schlae/EGACard/EGACard.kicad_sch

## KiCad design EGACard.kicad_sch (2024-01-29)

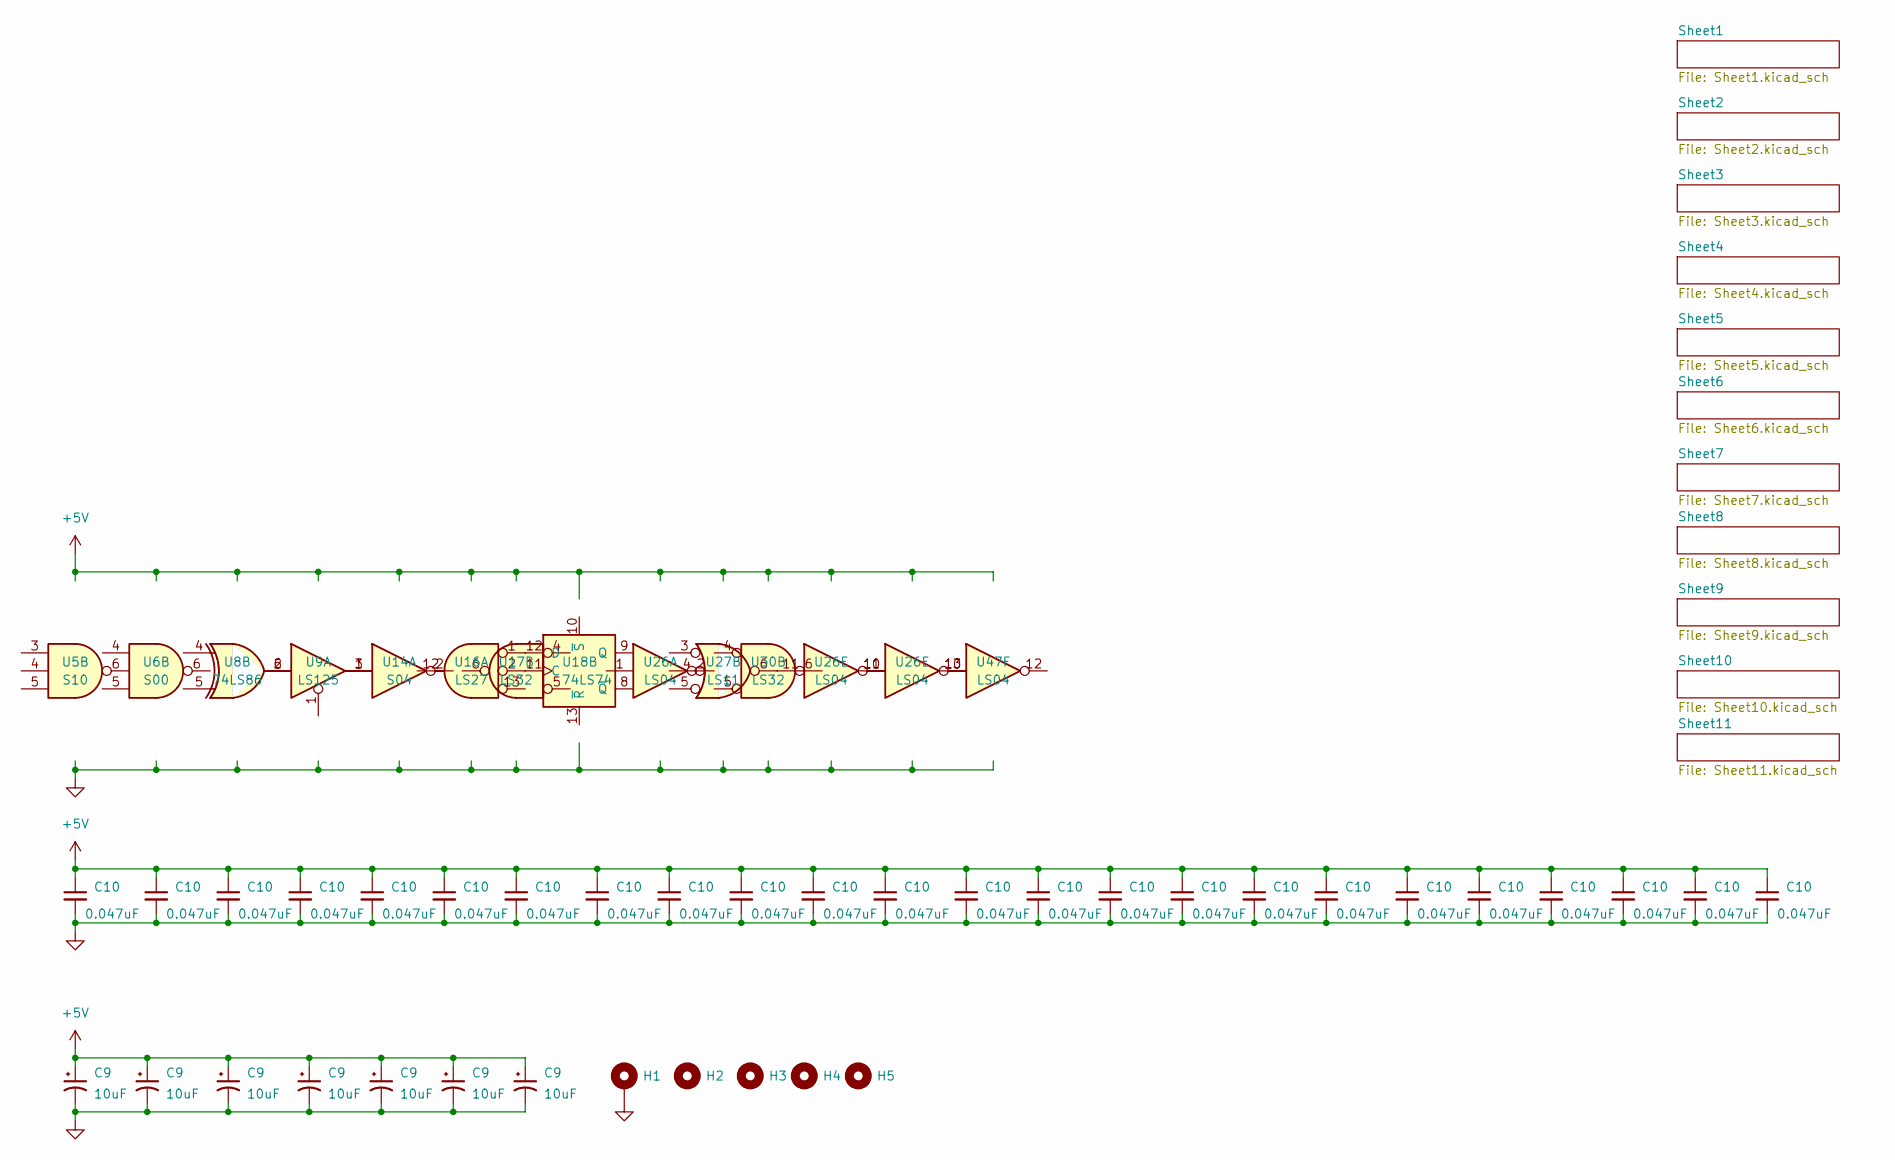
[picture p2: schematic EGACard.kicad_sch]

Parts:
C9: 10uF; CAPAP200_ALT
C10: 0.047uF; CAPAC1234
H1: MountingHole_Pad; MH125
H2: MountingHole; MH125_NOPAD
H3, H4, H5: MountingHole; MH156_NOPAD
U5: S10; DIP254P762X635-14
U6: S00; DIP254P762X635-14
U8: 74LS86; DIP254P762X635-14
U9: LS125; DIP254P762X635-14
U14: S04; DIP254P762X635-14
U16: LS27; DIP254P762X635-14
U17, U30: LS32; DIP254P762X635-14
U18: 74LS74; DIP254P762X635-14
U26, U47: LS04; DIP254P762X635-14
U27: LS11; DIP254P762X635-14

Connections:
+5V: C9.1, C10.1
GND: C9.2, C10.2, H1.1
unnamed: U16.1, U18.12 (D)
unnamed: U16.2, U18.11 (C)
unnamed: U26.11, U27.6
