schlae/EGACard/Sheet1.kicad_sch

## KiCad design Sheet1.kicad_sch (2024-01-20)

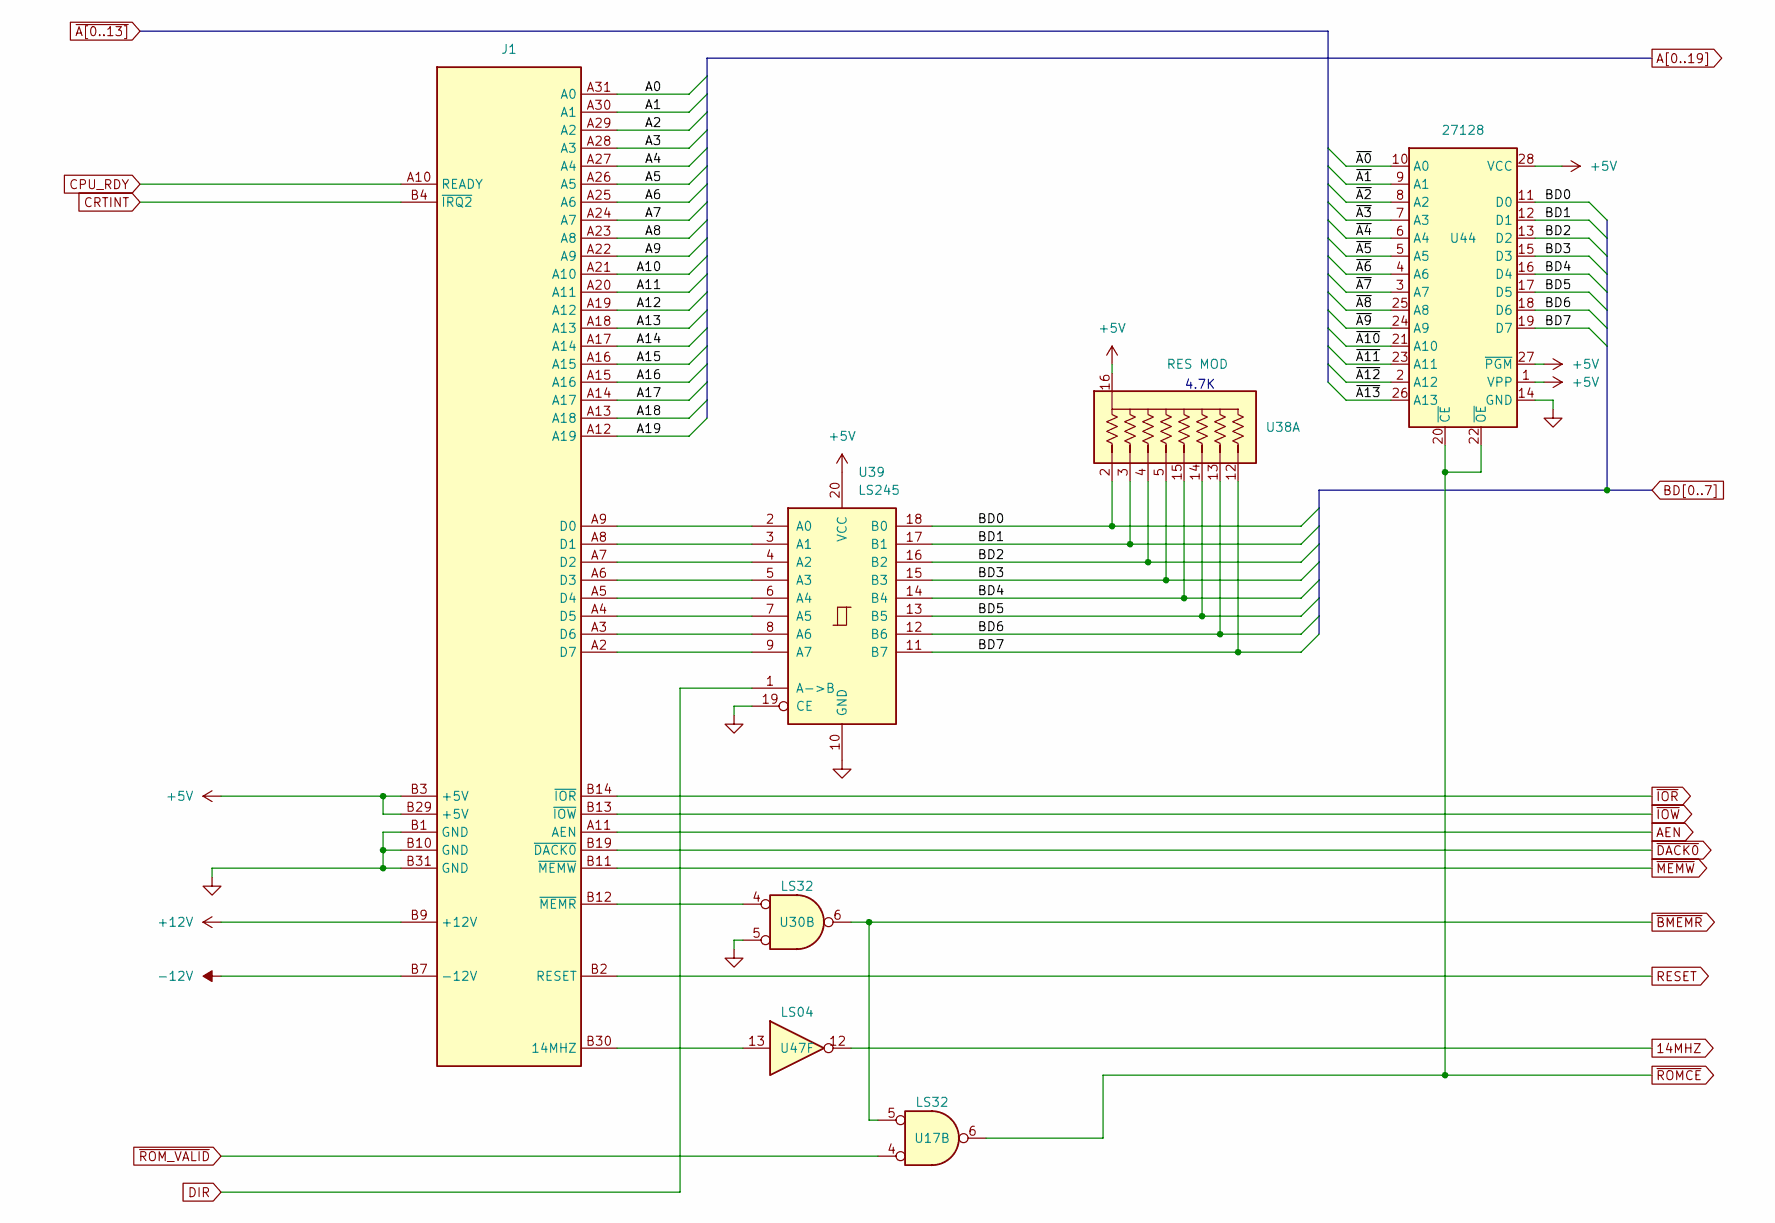
[picture p3: schematic Sheet1.kicad_sch]

Parts:
J1: BUS_PC_8BIT
U17, U30: LS32; DIP254P762X635-14
U38: RES MOD; DIP254P762X635-16
U39: LS245; DIP254P762X635-20
U44: 27128; DIP254P1524X635-28
U47: LS04; DIP254P762X635-14

Connections:
14MHZ: U47.12
+5V: J1.B3 (+5V), J1.B29 (+5V), U38.16, U39.20 (VCC), U44.1 (VPP), U44.27 (~PGM), U44.28 (VCC)
+12V: J1.B9 (+12V)
-12V: J1.B7 (-12V)
A0: J1.A31 (A0)
A1: J1.A30 (A1)
A2: J1.A29 (A2)
A3: J1.A28 (A3)
A4: J1.A27 (A4)
A5: J1.A26 (A5)
A6: J1.A25 (A6)
A7: J1.A24 (A7)
A8: J1.A23 (A8)
A9: J1.A22 (A9)
A10: J1.A21 (A10)
A11: J1.A20 (A11)
A12: J1.A19 (A12)
A13: J1.A18 (A13)
A14: J1.A17 (A14)
A15: J1.A16 (A15)
A16: J1.A15 (A16)
A17: J1.A14 (A17)
A18: J1.A13 (A18)
A19: J1.A12 (A19)
AEN: J1.A11 (AEN)
BD0: U38.2, U39.18 (B0), U44.11 (D0)
BD1: U38.3, U39.17 (B1), U44.12 (D1)
BD2: U38.4, U39.16 (B2), U44.13 (D2)
BD3: U38.5, U39.15 (B3), U44.15 (D3)
BD4: U38.15, U39.14 (B4), U44.16 (D4)
BD5: U38.14, U39.13 (B5), U44.17 (D5)
BD6: U38.13, U39.12 (B6), U44.18 (D6)
BD7: U38.12, U39.11 (B7), U44.19 (D7)
CPU_RDY: J1.A10 (READY)
CRTINT: J1.B4 (~IRQ2)
DIR: U39.1 (A->B)
GND: J1.B1 (GND), J1.B10 (GND), J1.B31 (GND), U30.5, U39.10 (GND), U39.19 (CE), U44.14 (GND)
unnamed: J1.A2 (D7), U39.9 (A7)
unnamed: J1.A3 (D6), U39.8 (A6)
unnamed: J1.A4 (D5), U39.7 (A5)
unnamed: J1.A5 (D4), U39.6 (A4)
unnamed: J1.A6 (D3), U39.5 (A3)
unnamed: J1.A7 (D2), U39.4 (A2)
unnamed: J1.A8 (D1), U39.3 (A1)
unnamed: J1.A9 (D0), U39.2 (A0)
unnamed: J1.B12 (~MEMR), U30.4
unnamed: J1.B30 (14MHZ), U47.13
RESET: J1.B2 (RESET)
~A0: U44.10 (A0)
~A1: U44.9 (A1)
~A2: U44.8 (A2)
~A3: U44.7 (A3)
~A4: U44.6 (A4)
~A5: U44.5 (A5)
~A6: U44.4 (A6)
~A7: U44.3 (A7)
~A8: U44.25 (A8)
~A9: U44.24 (A9)
~A10: U44.21 (A10)
~A11: U44.23 (A11)
~A12: U44.2 (A12)
~A13: U44.26 (A13)
~BMEMR: U17.5, U30.6
~DACK0: J1.B19 (~DACK0)
~IOR: J1.B14 (~IOR)
~IOW: J1.B13 (~IOW)
~MEMW: J1.B11 (~MEMW)
~ROMCE: U17.6, U44.20 (~CE), U44.22 (~OE)
~ROM_VALID: U17.4

Notes on the sheet:
4.7K
