schlae/EGACard/Sheet2.kicad_sch

## KiCad design Sheet2.kicad_sch (2024-01-29)

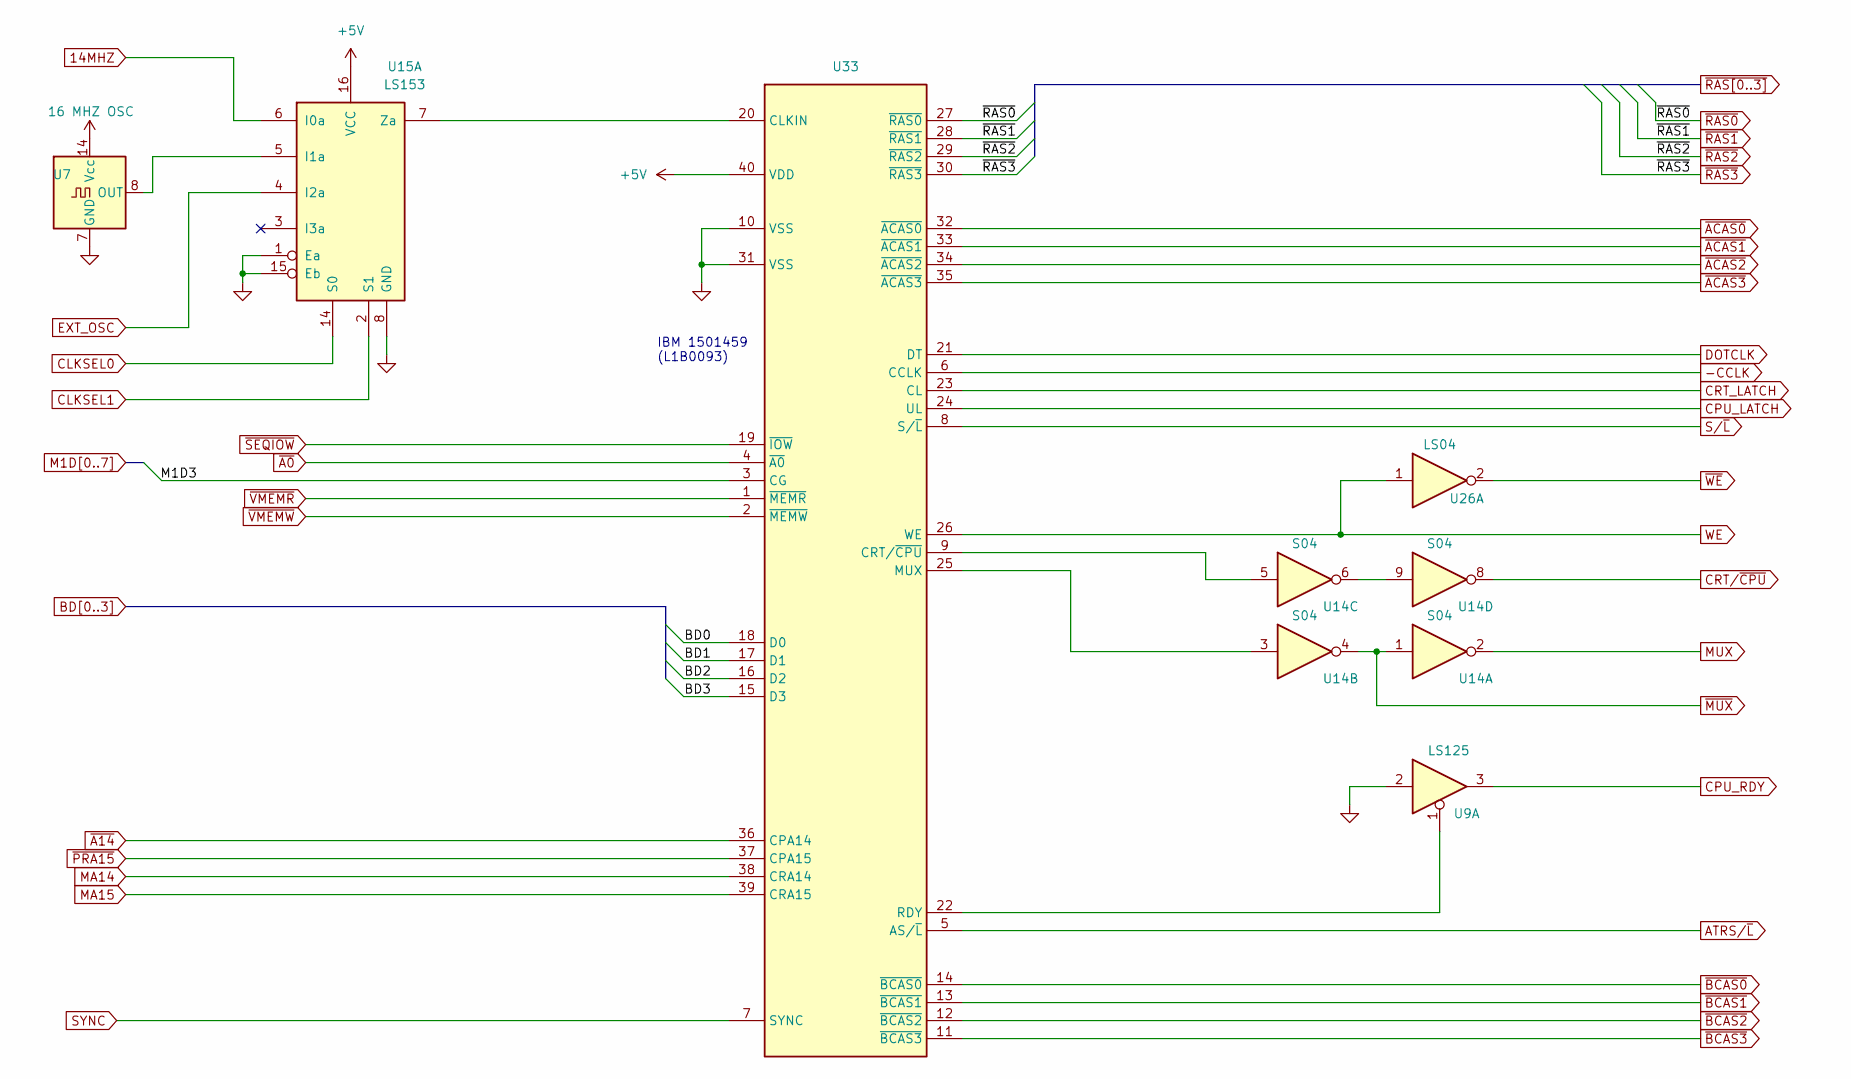
[picture p4: schematic Sheet2.kicad_sch]

Parts:
U7: 16 MHZ OSC; DIP254P762X635-14_ALT
U9: LS125; DIP254P762X635-14
U14: S04; DIP254P762X635-14
U15: LS153; DIP254P762X635-16
U26: LS04; DIP254P762X635-14
U33: DIP254P1524X635-40

Connections:
14MHZ: U15.6 (I0a)
+5V: U7.14 (Vcc), U15.16 (VCC), U33.40 (VDD)
-CCLK: U33.6 (CCLK)
ATRS/~L: U33.5 (AS/~L)
BD0: U33.18 (D0)
BD1: U33.17 (D1)
BD2: U33.16 (D2)
BD3: U33.15 (D3)
CLKSEL0: U15.14 (S0)
CLKSEL1: U15.2 (S1)
CPU_LATCH: U33.24 (UL)
CPU_RDY: U9.3
CRT_LATCH: U33.23 (CL)
CRT/~CPU: U14.8
DOTCLK: U33.21 (DT)
EXT_OSC: U15.4 (I2a)
GND: U7.7 (GND), U9.2, U15.1 (Ea), U15.8 (GND), U15.15 (Eb), U33.10 (VSS), U33.31 (VSS)
M1D3: U33.3 (CG)
MA14: U33.38 (CRA14)
MA15: U33.39 (CRA15)
MUX: U14.2
unnamed: U14.3, U33.25 (MUX)
unnamed: U14.5, U33.9 (CRT/~CPU)
unnamed: U14.6, U14.9
unnamed: U7.8 (OUT), U15.5 (I1a)
unnamed: U15.7 (Za), U33.20 (CLKIN)
unnamed: U9.1, U33.22 (RDY)
SYNC: U33.7 (SYNC)
S/~L: U33.8 (S/~L)
WE: U26.1, U33.26 (WE)
~A0: U33.4 (~A0)
~A14: U33.36 (CPA14)
~ACAS0: U33.32 (~ACAS0)
~ACAS1: U33.33 (~ACAS1)
~ACAS2: U33.34 (~ACAS2)
~ACAS3: U33.35 (~ACAS3)
~BCAS0: U33.14 (~BCAS0)
~BCAS1: U33.13 (~BCAS1)
~BCAS2: U33.12 (~BCAS2)
~BCAS3: U33.11 (~BCAS3)
~MUX: U14.1, U14.4
~PRA15: U33.37 (CPA15)
~RAS0: U33.27 (~RAS0)
~RAS1: U33.28 (~RAS1)
~RAS2: U33.29 (~RAS2)
~RAS3: U33.30 (~RAS3)
~SEQIOW: U33.19 (~IOW)
~VMEMR: U33.1 (~MEMR)
~VMEMW: U33.2 (~MEMW)
~WE: U26.2

Notes on the sheet:
IBM 1501459 (L1B0093)
