schlae/EGACard/Sheet3.kicad_sch

## KiCad design Sheet3.kicad_sch (2024-01-29)

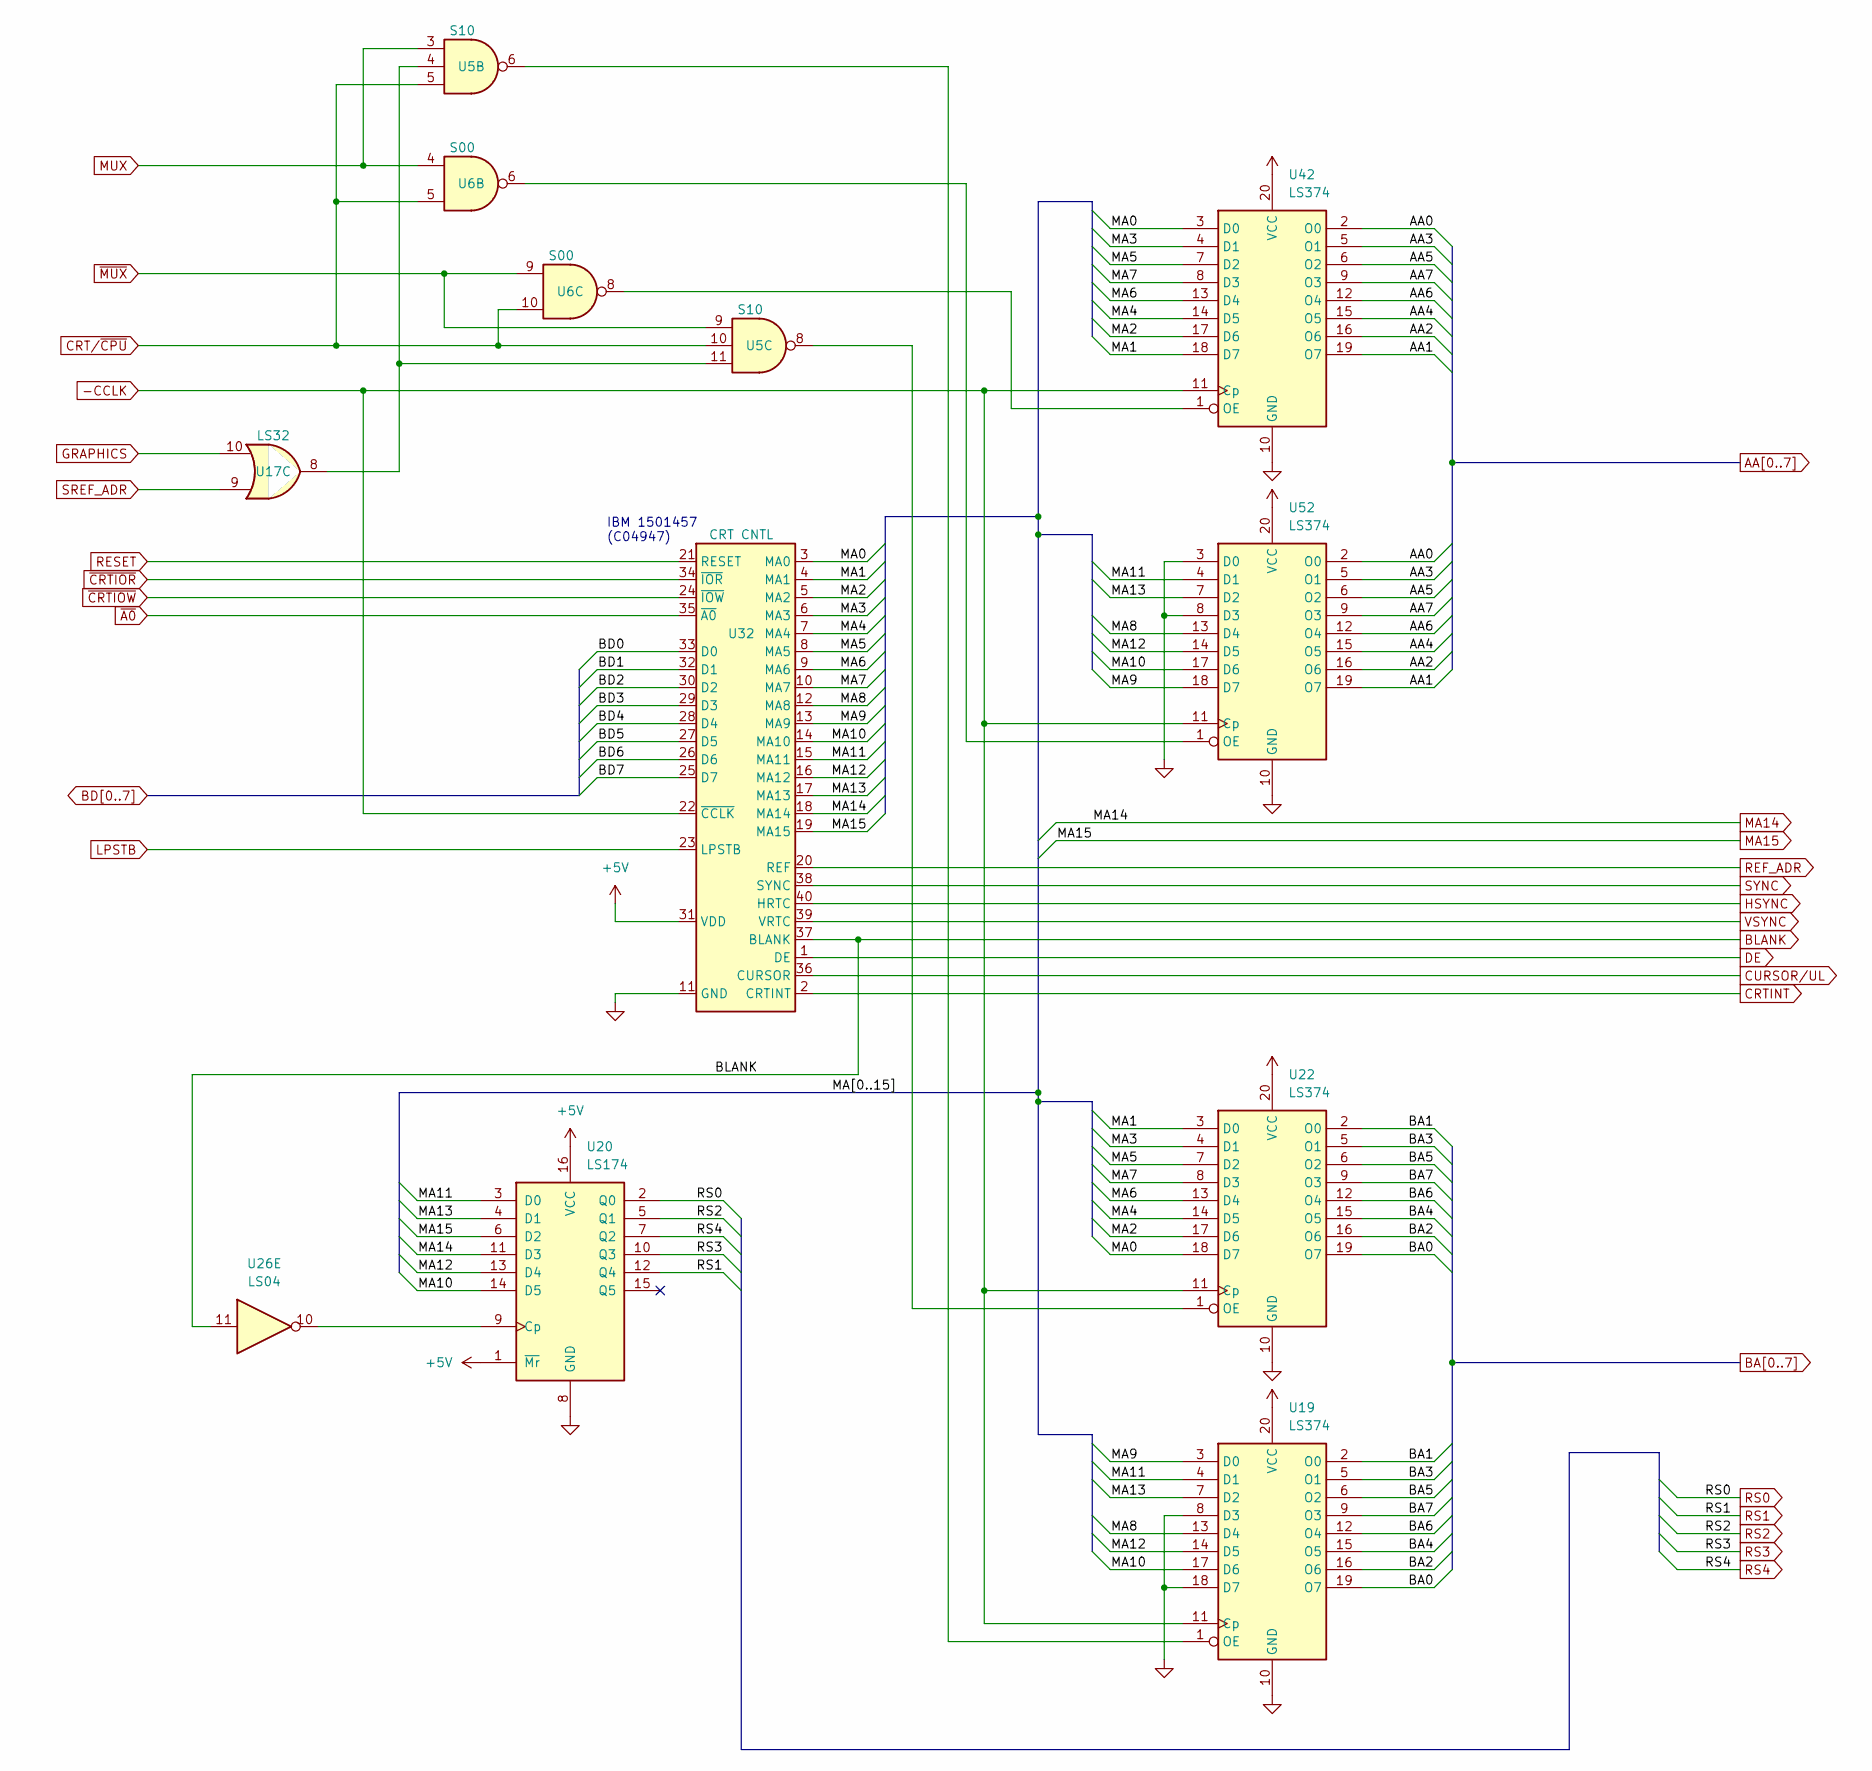
[picture p5: schematic Sheet3.kicad_sch]

Parts:
U5: S10; DIP254P762X635-14
U6: S00; DIP254P762X635-14
U17: LS32; DIP254P762X635-14
U19, U22, U42, U52: LS374; DIP254P762X635-20
U20: LS174; DIP254P762X635-16
U26: LS04; DIP254P762X635-14
U32: CRT CNTL; DIP254P1524X635-40

Connections:
+5V: U19.20 (VCC), U20.1 (~Mr), U20.16 (VCC), U22.20 (VCC), U32.31 (VDD), U42.20 (VCC), U52.20 (VCC)
-CCLK: U19.11 (Cp), U22.11 (Cp), U32.22 (~CCLK), U42.11 (Cp), U52.11 (Cp)
AA0: U42.2 (O0), U52.2 (O0)
AA1: U42.19 (O7), U52.19 (O7)
AA2: U42.16 (O6), U52.16 (O6)
AA3: U42.5 (O1), U52.5 (O1)
AA4: U42.15 (O5), U52.15 (O5)
AA5: U42.6 (O2), U52.6 (O2)
AA6: U42.12 (O4), U52.12 (O4)
AA7: U42.9 (O3), U52.9 (O3)
BA0: U19.19 (O7), U22.19 (O7)
BA1: U19.2 (O0), U22.2 (O0)
BA2: U19.16 (O6), U22.16 (O6)
BA3: U19.5 (O1), U22.5 (O1)
BA4: U19.15 (O5), U22.15 (O5)
BA5: U19.6 (O2), U22.6 (O2)
BA6: U19.12 (O4), U22.12 (O4)
BA7: U19.9 (O3), U22.9 (O3)
BD0: U32.33 (D0)
BD1: U32.32 (D1)
BD2: U32.30 (D2)
BD3: U32.29 (D3)
BD4: U32.28 (D4)
BD5: U32.27 (D5)
BD6: U32.26 (D6)
BD7: U32.25 (D7)
BLANK: U26.11, U32.37 (BLANK)
CRTINT: U32.2 (CRTINT)
CRT/~CPU: U5.5, U5.10, U6.5, U6.10
CURSOR/UL: U32.36 (CURSOR)
DE: U32.1 (DE)
GND: U19.8 (D3), U19.10 (GND), U19.18 (D7), U20.8 (GND), U22.10 (GND), U32.11 (GND), U42.10 (GND), U52.3 (D0), U52.8 (D3), U52.10 (GND)
GRAPHICS: U17.10
HSYNC: U32.40 (HRTC)
LPSTB: U32.23 (LPSTB)
MA0: U22.18 (D7), U32.3 (MA0), U42.3 (D0)
MA1: U22.3 (D0), U32.4 (MA1), U42.18 (D7)
MA2: U22.17 (D6), U32.5 (MA2), U42.17 (D6)
MA3: U22.4 (D1), U32.6 (MA3), U42.4 (D1)
MA4: U22.14 (D5), U32.7 (MA4), U42.14 (D5)
MA5: U22.7 (D2), U32.8 (MA5), U42.7 (D2)
MA6: U22.13 (D4), U32.9 (MA6), U42.13 (D4)
MA7: U22.8 (D3), U32.10 (MA7), U42.8 (D3)
MA8: U19.13 (D4), U32.12 (MA8), U52.13 (D4)
MA9: U19.3 (D0), U32.13 (MA9), U52.18 (D7)
MA10: U19.17 (D6), U20.14 (D5), U32.14 (MA10), U52.17 (D6)
MA11: U19.4 (D1), U20.3 (D0), U32.15 (MA11), U52.4 (D1)
MA12: U19.14 (D5), U20.13 (D4), U32.16 (MA12), U52.14 (D5)
MA13: U19.7 (D2), U20.4 (D1), U32.17 (MA13), U52.7 (D2)
MA14: U20.11 (D3), U32.18 (MA14)
MA15: U20.6 (D2), U32.19 (MA15)
MUX: U5.3, U6.4
unnamed: U5.4, U5.11, U17.8
unnamed: U5.6, U19.1 (OE)
unnamed: U20.9 (Cp), U26.10
unnamed: U5.8, U22.1 (OE)
unnamed: U6.8, U42.1 (OE)
unnamed: U6.6, U52.1 (OE)
REF_ADR: U32.20 (REF)
RESET: U32.21 (RESET)
RS0: U20.2 (Q0)
RS1: U20.12 (Q4)
RS2: U20.5 (Q1)
RS3: U20.10 (Q3)
RS4: U20.7 (Q2)
SREF_ADR: U17.9
SYNC: U32.38 (SYNC)
VSYNC: U32.39 (VRTC)
~A0: U32.35 (~A0)
~CRTIOR: U32.34 (~IOR)
~CRTIOW: U32.24 (~IOW)
~MUX: U5.9, U6.9

Notes on the sheet:
IBM 1501457 (C04947)
