schlae/EGACard/Sheet4.kicad_sch

## KiCad design Sheet4.kicad_sch (2024-01-20)

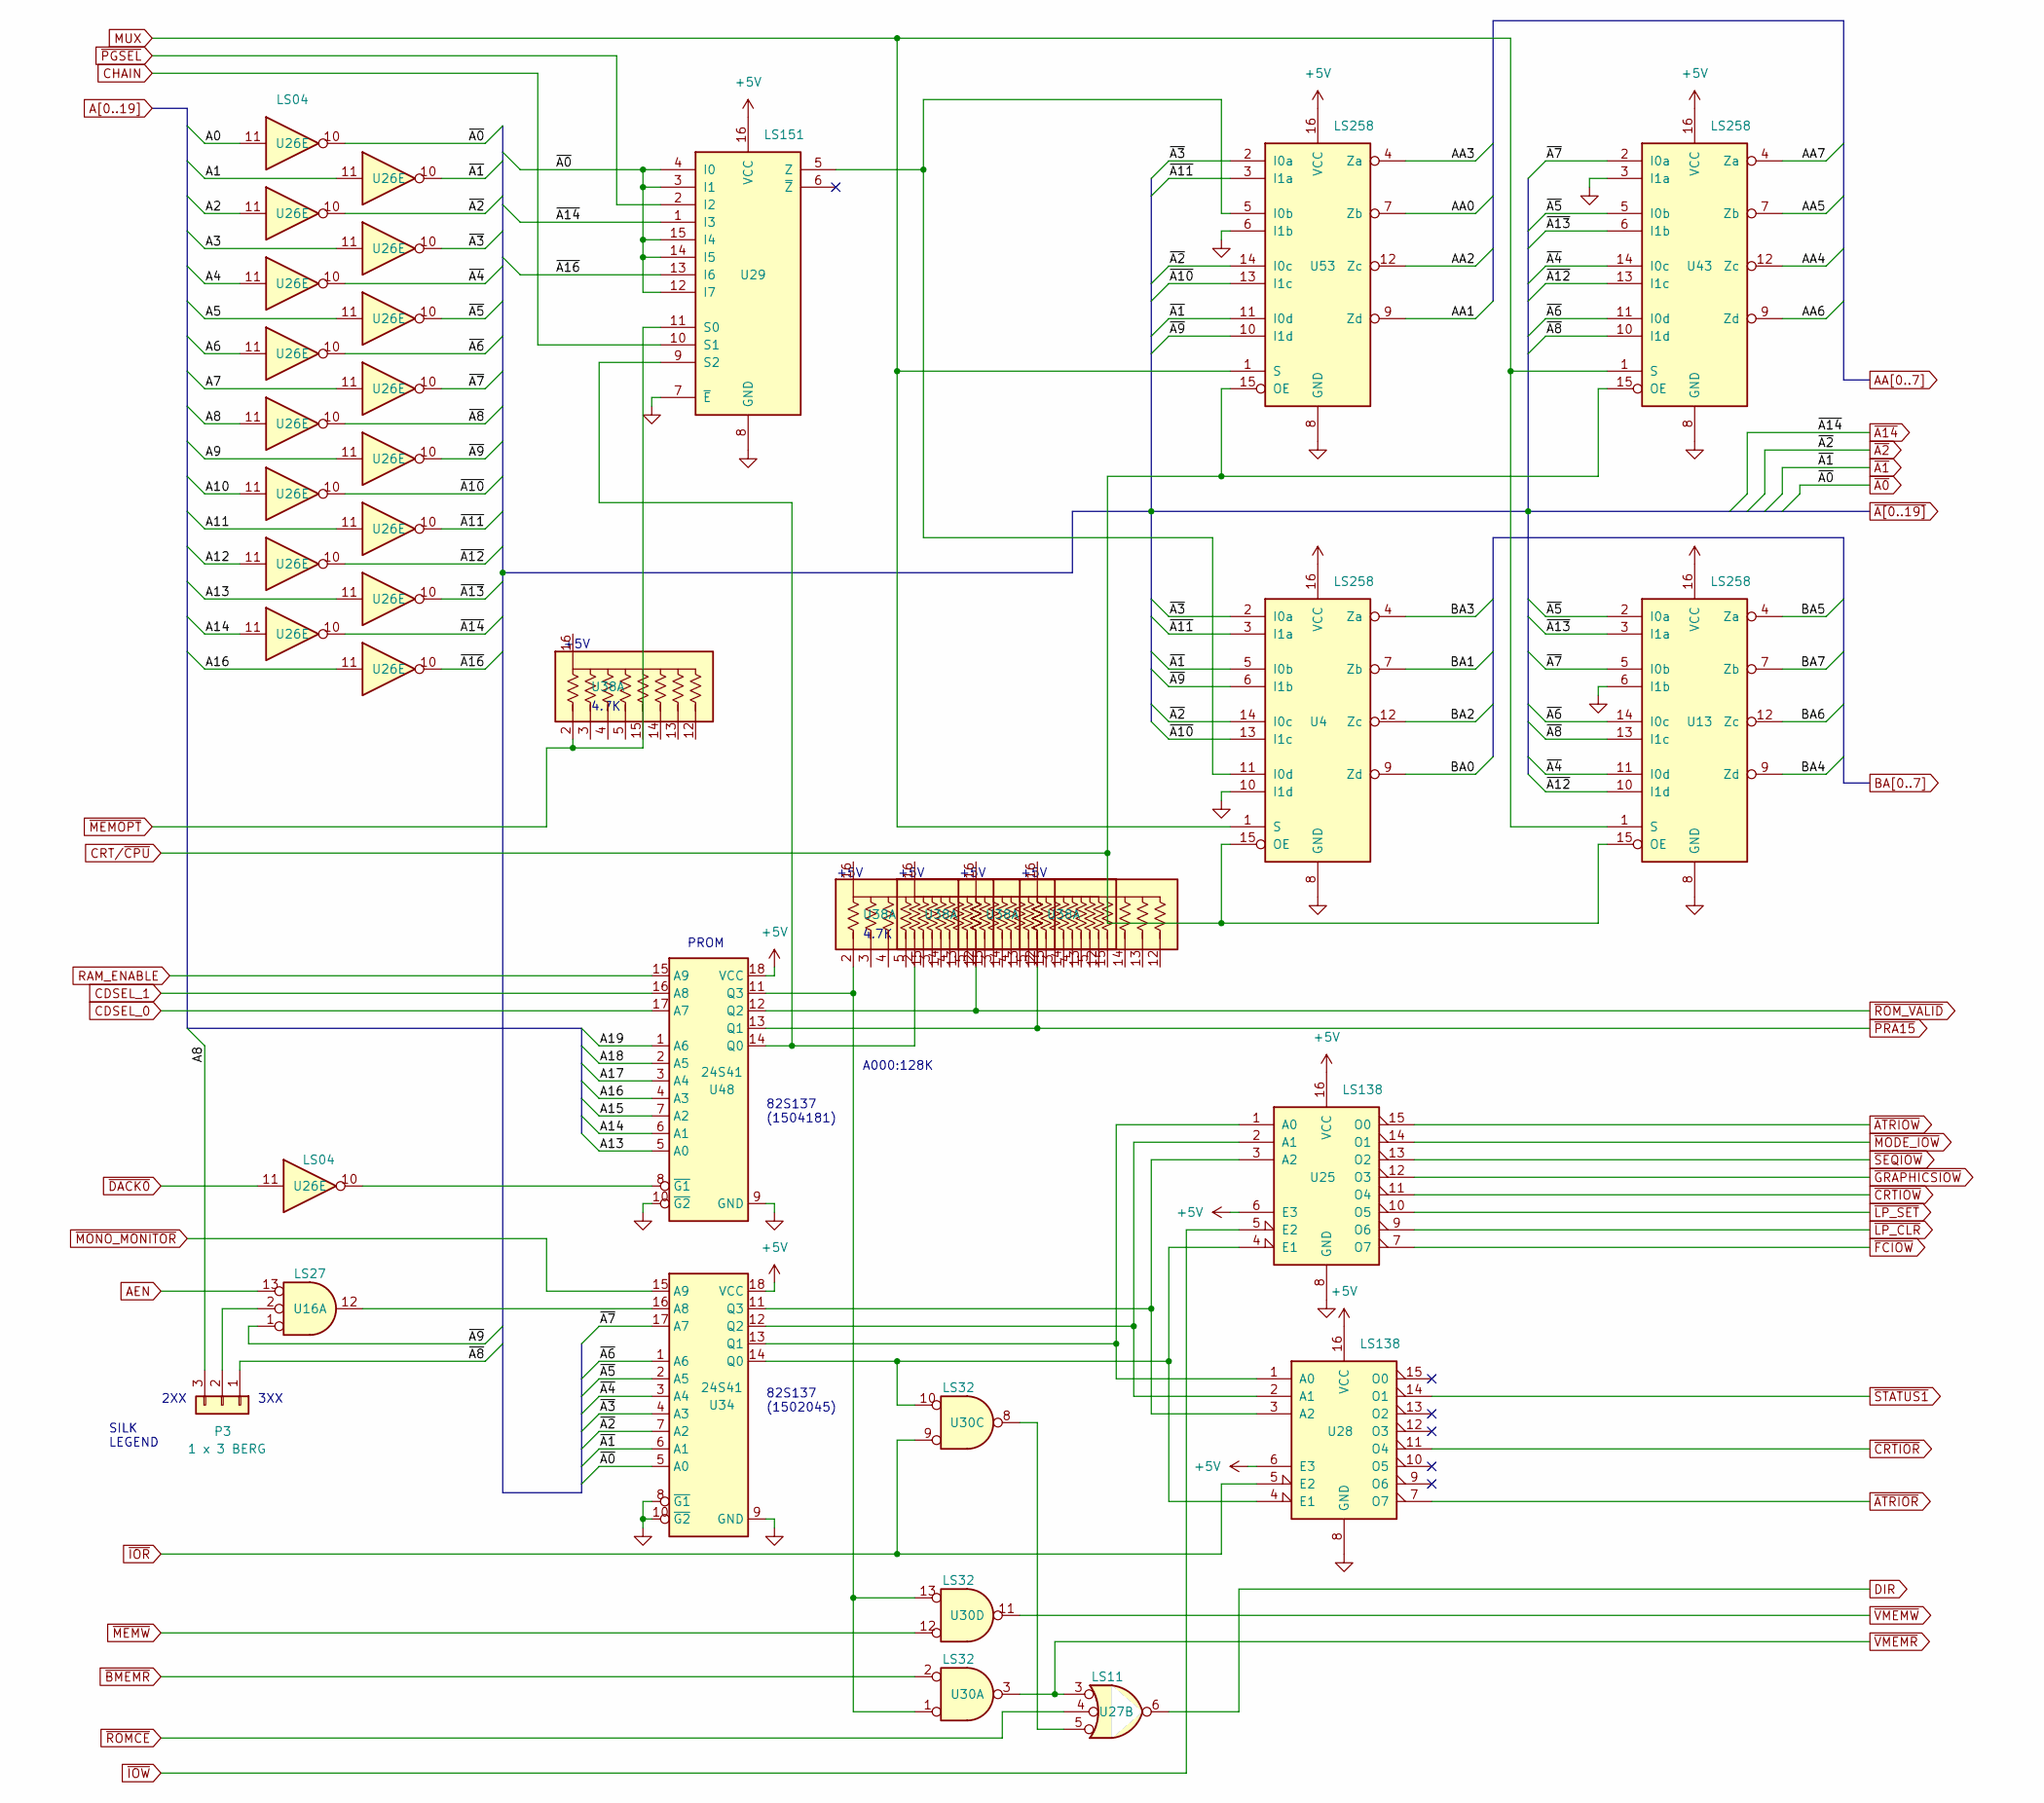
[picture p6: schematic Sheet4.kicad_sch]

Parts:
P3: 1 x 3 BERG; PinHeader_1x03_P2.54mm_Vertical
U4, U13, U43, U53: LS258; DIP254P762X635-16
U16: LS27; DIP254P762X635-14
U25, U28: LS138; DIP254P762X635-16
U26: LS04; DIP254P762X635-14
U27: LS11; DIP254P762X635-14
U29: LS151; DIP254P762X635-16
U30: LS32; DIP254P762X635-14
U34, U48: 24S41; DIP254P762X635-18
U38: RES MOD; DIP254P762X635-16

Connections:
+5V: U4.16 (VCC), U13.16 (VCC), U25.6 (E3), U25.16 (VCC), U28.6 (E3), U28.16 (VCC), U29.16 (VCC), U34.18 (VCC), U43.16 (VCC), U48.18 (VCC), U53.16 (VCC)
A0: U26.11
A1: U26.11
A2: U26.11
A3: U26.11
A4: U26.11
A5: U26.11
A6: U26.11
A7: U26.11
A8: P3.3, U26.11
A9: U26.11
A10: U26.11
A11: U26.11
A12: U26.11
A13: U26.11, U48.5 (A0)
A14: U26.11, U48.6 (A1)
A15: U48.7 (A2)
A16: U26.11, U48.4 (A3)
A17: U48.3 (A4)
A18: U48.2 (A5)
A19: U48.1 (A6)
AA0: U53.7 (Zb)
AA1: U53.9 (Zd)
AA2: U53.12 (Zc)
AA3: U53.4 (Za)
AA4: U43.12 (Zc)
AA5: U43.7 (Zb)
AA6: U43.9 (Zd)
AA7: U43.4 (Za)
AEN: U16.13
BA0: U4.9 (Zd)
BA1: U4.7 (Zb)
BA2: U4.12 (Zc)
BA3: U4.4 (Za)
BA4: U13.9 (Zd)
BA5: U13.4 (Za)
BA6: U13.12 (Zc)
BA7: U13.7 (Zb)
CDSEL_0: U48.17 (A7)
CDSEL_1: U48.16 (A8)
CHAIN: U29.10 (S1)
CRT/~CPU: U4.15 (OE), U13.15 (OE), U43.15 (OE), U53.15 (OE)
DIR: U27.6
GND: U4.8 (GND), U4.10 (I1d), U13.6 (I1b), U13.8 (GND), U25.8 (GND), U28.8 (GND), U29.7 (~E), U29.8 (GND), U34.8 (~G1), U34.9 (GND), U34.10 (~G2), U43.3 (I1a), U43.8 (GND), U48.9 (GND), U48.10 (~G2), U53.6 (I1b), U53.8 (GND)
MUX: U4.1 (S), U13.1 (S), U43.1 (S), U53.1 (S)
unnamed: P3.2, U16.2
unnamed: U16.12, U34.16 (A8)
unnamed: U25.1 (A0), U28.1 (A0), U34.13 (Q1)
unnamed: U25.2 (A1), U28.2 (A1), U34.12 (Q2)
unnamed: U25.3 (A2), U28.3 (A2), U34.11 (Q3)
unnamed: U25.4 (E1), U28.4 (E1), U30.10, U34.14 (Q0)
unnamed: U26.10, U48.8 (~G1)
unnamed: U27.5, U30.8
unnamed: U4.11 (I0d), U29.5 (Z), U53.5 (I0b)
unnamed: U29.9 (S2), U38.2, U48.14 (Q0)
unnamed: U30.1, U30.13, U38.2, U48.11 (Q3)
RAM_ENABLE: U48.15 (A9)
~A0: U26.10, U29.3 (I1), U29.4 (I0), U29.12 (I7), U29.14 (I5), U29.15 (I4), U34.5 (A0)
~A1: U4.5 (I0b), U26.10, U34.6 (A1), U53.11 (I0d)
~A2: U4.14 (I0c), U26.10, U34.7 (A2), U53.14 (I0c)
~A3: U4.2 (I0a), U26.10, U34.4 (A3), U53.2 (I0a)
~A4: U13.11 (I0d), U26.10, U34.3 (A4), U43.14 (I0c)
~A5: U13.2 (I0a), U26.10, U34.2 (A5), U43.5 (I0b)
~A6: U13.14 (I0c), U26.10, U34.1 (A6), U43.11 (I0d)
~A7: U13.5 (I0b), U26.10, U34.17 (A7), U43.2 (I0a)
~A8: P3.1, U13.13 (I1c), U26.10, U43.10 (I1d)
~A9: U4.6 (I1b), U16.1, U26.10, U53.10 (I1d)
~A10: U4.13 (I1c), U26.10, U53.13 (I1c)
~A11: U4.3 (I1a), U26.10, U53.3 (I1a)
~A12: U13.10 (I1d), U26.10, U43.13 (I1c)
~A13: U13.3 (I1a), U26.10, U43.6 (I1b)
~A14: U26.10, U29.1 (I3)
~A16: U26.10, U29.13 (I6)
~ATRIOR: U28.7 (O7)
~ATRIOW: U25.15 (O0)
~BMEMR: U30.2
~CRTIOR: U28.11 (O4)
~CRTIOW: U25.11 (O4)
~DACK0: U26.11
~FCIOW: U25.7 (O7)
~GRAPHICSIOW: U25.12 (O3)
~IOR: U28.5 (E2), U30.9
~IOW: U25.5 (E2)
~LP_CLR: U25.9 (O6)
~LP_SET: U25.10 (O5)
~MEMOPT: U29.11 (S0), U38.2
~MEMW: U30.12
~MODE_IOW: U25.14 (O1)
~MONO_MONITOR: U34.15 (A9)
~PGSEL: U29.2 (I2)
~PRA15: U38.2, U38.12, U48.13 (Q1)
~ROMCE: U27.4
~ROM_VALID: U38.2, U38.12, U48.12 (Q2)
~SEQIOW: U25.13 (O2)
~STATUS1: U28.14 (O1)
~VMEMR: U27.3, U30.3
~VMEMW: U30.11

Notes on the sheet:
82S137 (1504181)
+5V
PROM
4.7K
A000:128K
2XX
82S137 (1502045)
SILK LEGEND
3XX
