schlae/EGACard/Sheet5.kicad_sch

## KiCad design Sheet5.kicad_sch (2024-01-29)

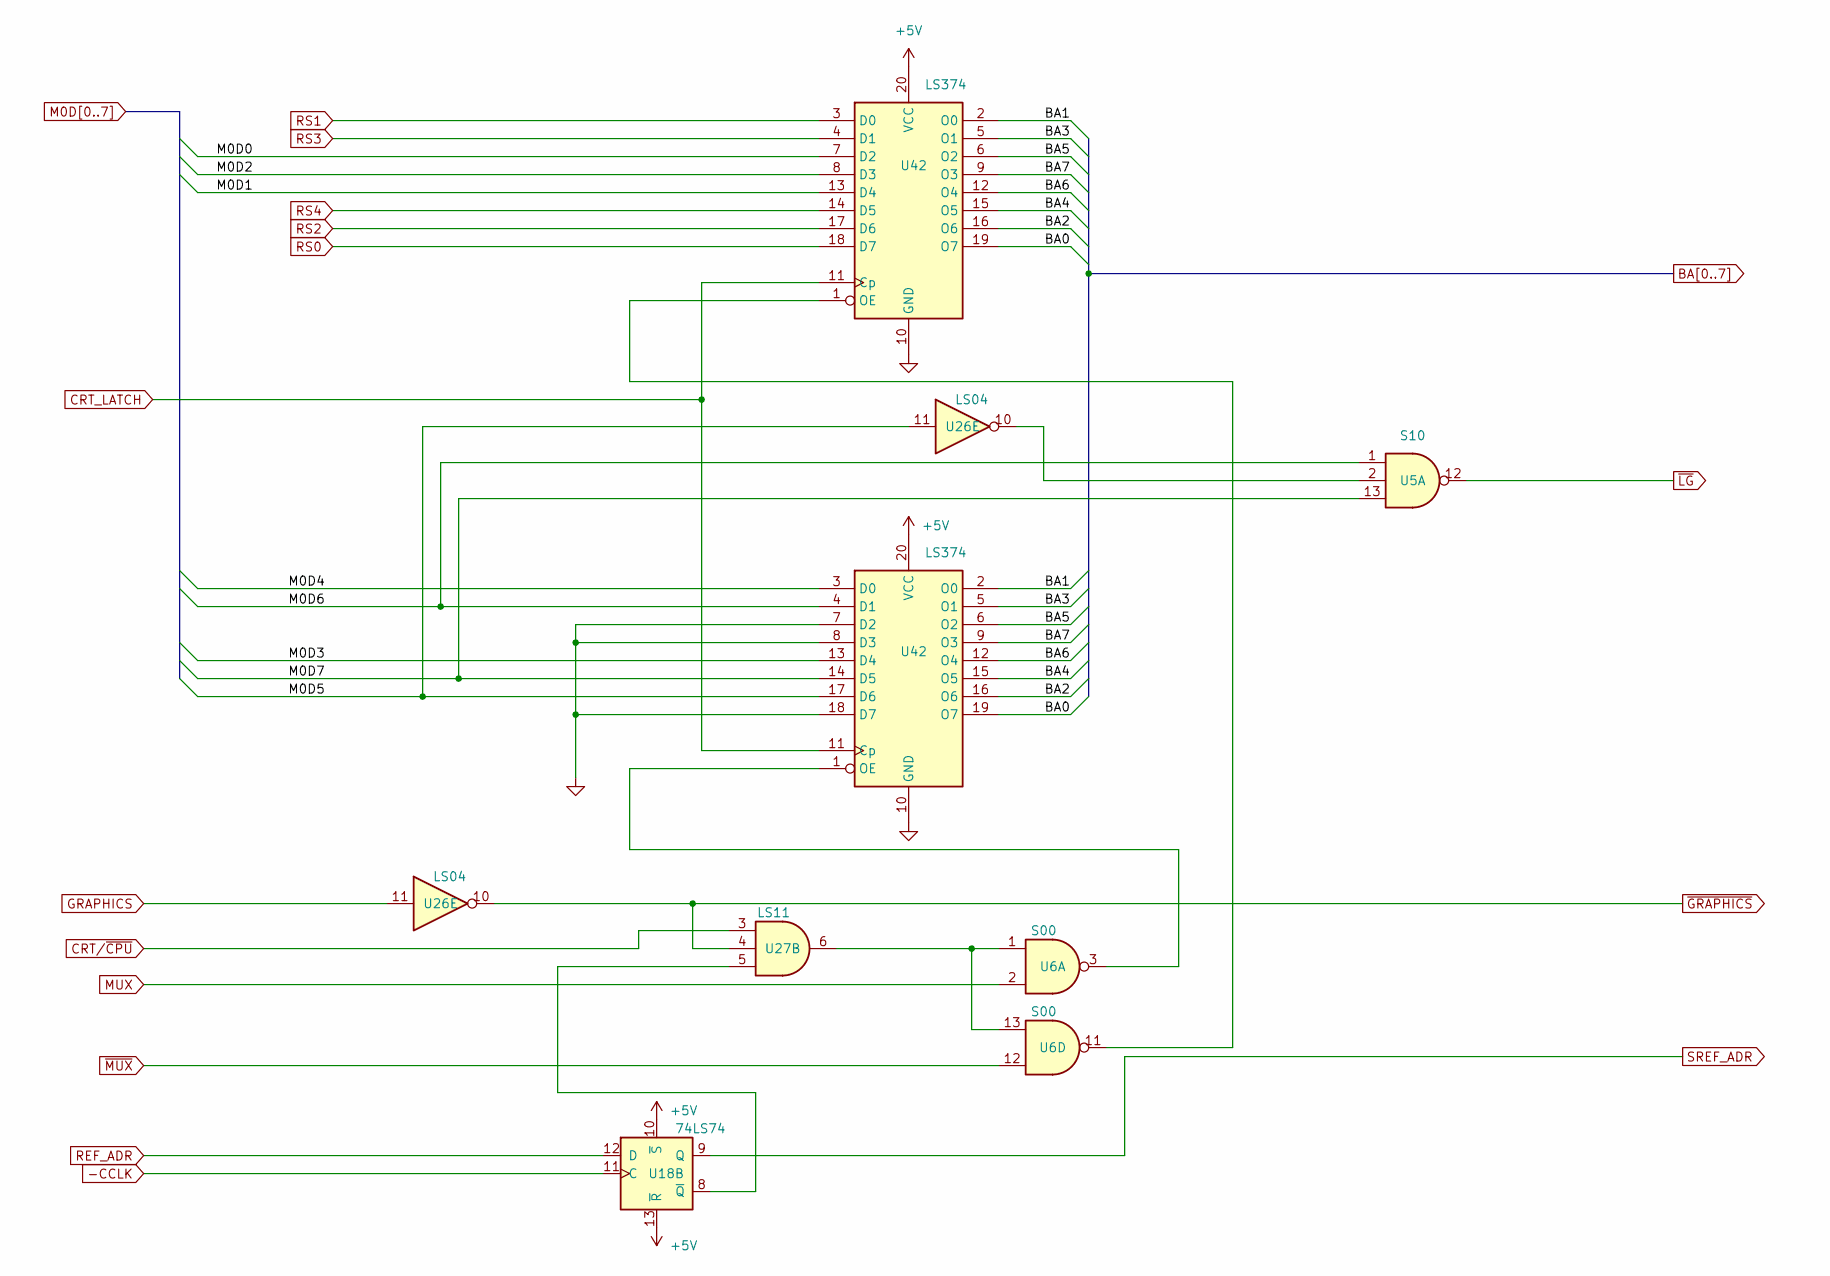
[picture p7: schematic Sheet5.kicad_sch]

Parts:
U5: S10; DIP254P762X635-14
U6: S00; DIP254P762X635-14
U18: 74LS74; DIP254P762X635-14
U26: LS04; DIP254P762X635-14
U27: LS11; DIP254P762X635-14
U42: LS374; DIP254P762X635-20

Connections:
+5V: U18.10 (~S), U18.13 (~R), U42.20 (VCC)
-CCLK: U18.11 (C)
BA0: U42.19 (O7)
BA1: U42.2 (O0)
BA2: U42.16 (O6)
BA3: U42.5 (O1)
BA4: U42.15 (O5)
BA5: U42.6 (O2)
BA6: U42.12 (O4)
BA7: U42.9 (O3)
CRT_LATCH: U42.11 (Cp)
CRT/~CPU: U27.3
GND: U42.7 (D2), U42.8 (D3), U42.10 (GND), U42.18 (D7)
GRAPHICS: U26.11
M0D0: U42.7 (D2)
M0D1: U42.13 (D4)
M0D2: U42.8 (D3)
M0D3: U42.13 (D4)
M0D4: U42.3 (D0)
M0D5: U26.11, U42.17 (D6)
M0D6: U5.1, U42.4 (D1)
M0D7: U5.13, U42.14 (D5)
MUX: U6.2
unnamed: U18.8 (~Q), U27.5
unnamed: U5.2, U26.10
unnamed: U6.1, U6.13, U27.6
unnamed: U6.3, U6.11, U42.1 (OE)
REF_ADR: U18.12 (D)
RS0: U42.18 (D7)
RS1: U42.3 (D0)
RS2: U42.17 (D6)
RS3: U42.4 (D1)
RS4: U42.14 (D5)
SREF_ADR: U18.9 (Q)
~GRAPHICS: U26.10, U27.4
~LG: U5.12
~MUX: U6.12
