schlae/EGACard/Sheet6.kicad_sch

## KiCad design Sheet6.kicad_sch (2024-01-20)

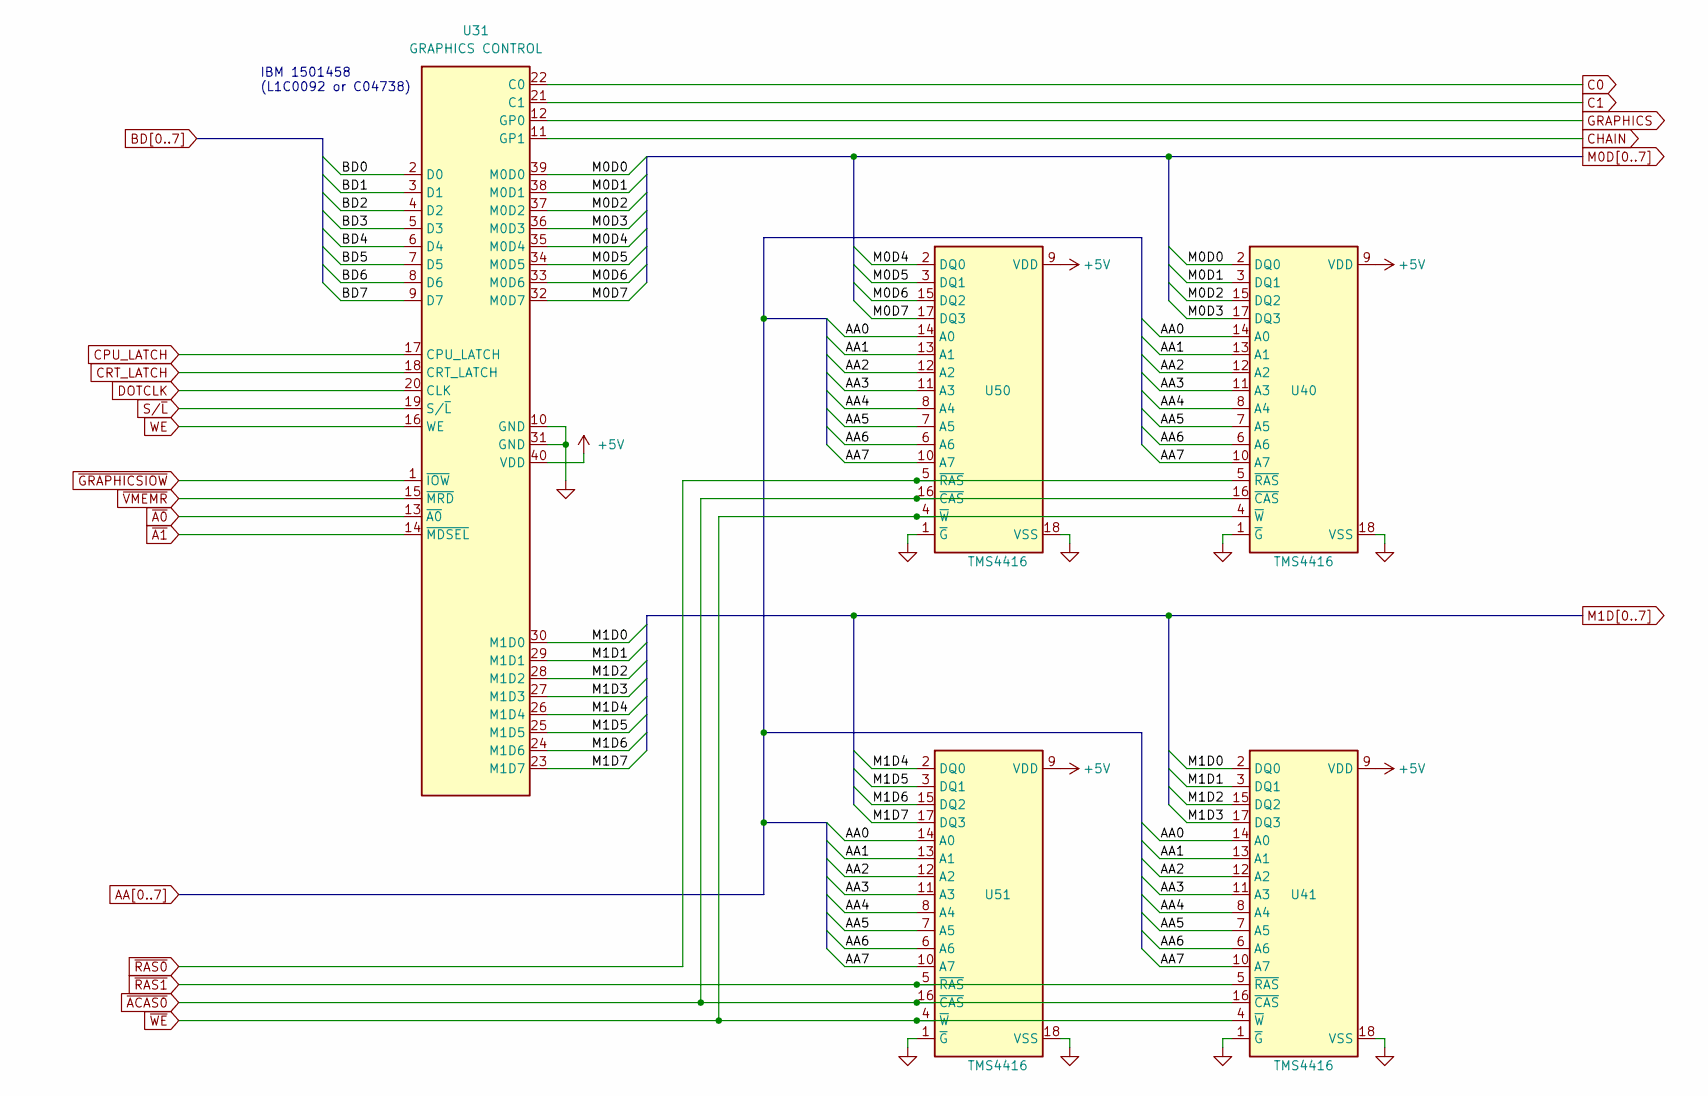
[picture p8: schematic Sheet6.kicad_sch]

Parts:
U31: GRAPHICS CONTROL; DIP254P1524X635-40
U40, U41, U50, U51: TMS4416; DIP254P762X635-18

Connections:
+5V: U31.40 (VDD), U40.9 (VDD), U41.9 (VDD), U50.9 (VDD), U51.9 (VDD)
AA0: U40.14 (A0), U41.14 (A0), U50.14 (A0), U51.14 (A0)
AA1: U40.13 (A1), U41.13 (A1), U50.13 (A1), U51.13 (A1)
AA2: U40.12 (A2), U41.12 (A2), U50.12 (A2), U51.12 (A2)
AA3: U40.11 (A3), U41.11 (A3), U50.11 (A3), U51.11 (A3)
AA4: U40.8 (A4), U41.8 (A4), U50.8 (A4), U51.8 (A4)
AA5: U40.7 (A5), U41.7 (A5), U50.7 (A5), U51.7 (A5)
AA6: U40.6 (A6), U41.6 (A6), U50.6 (A6), U51.6 (A6)
AA7: U40.10 (A7), U41.10 (A7), U50.10 (A7), U51.10 (A7)
BD0: U31.2 (D0)
BD1: U31.3 (D1)
BD2: U31.4 (D2)
BD3: U31.5 (D3)
BD4: U31.6 (D4)
BD5: U31.7 (D5)
BD6: U31.8 (D6)
BD7: U31.9 (D7)
C0: U31.22 (C0)
C1: U31.21 (C1)
CHAIN: U31.11 (GP1)
CPU_LATCH: U31.17 (CPU_LATCH)
CRT_LATCH: U31.18 (CRT_LATCH)
DOTCLK: U31.20 (CLK)
GND: U31.10 (GND), U31.31 (GND), U40.1 (~G), U40.18 (VSS), U41.1 (~G), U41.18 (VSS), U50.1 (~G), U50.18 (VSS), U51.1 (~G), U51.18 (VSS)
GRAPHICS: U31.12 (GP0)
M0D0: U31.39 (M0D0), U40.2 (DQ0)
M0D1: U31.38 (M0D1), U40.3 (DQ1)
M0D2: U31.37 (M0D2), U40.15 (DQ2)
M0D3: U31.36 (M0D3), U40.17 (DQ3)
M0D4: U31.35 (M0D4), U50.2 (DQ0)
M0D5: U31.34 (M0D5), U50.3 (DQ1)
M0D6: U31.33 (M0D6), U50.15 (DQ2)
M0D7: U31.32 (M0D7), U50.17 (DQ3)
M1D0: U31.30 (M1D0), U41.2 (DQ0)
M1D1: U31.29 (M1D1), U41.3 (DQ1)
M1D2: U31.28 (M1D2), U41.15 (DQ2)
M1D3: U31.27 (M1D3), U41.17 (DQ3)
M1D4: U31.26 (M1D4), U51.2 (DQ0)
M1D5: U31.25 (M1D5), U51.3 (DQ1)
M1D6: U31.24 (M1D6), U51.15 (DQ2)
M1D7: U31.23 (M1D7), U51.17 (DQ3)
S/~L: U31.19 (S/~L)
WE: U31.16 (WE)
~A0: U31.13 (~A0)
~A1: U31.14 (~MDSEL)
~ACAS0: U40.16 (~CAS), U41.16 (~CAS), U50.16 (~CAS), U51.16 (~CAS)
~GRAPHICSIOW: U31.1 (~IOW)
~RAS0: U40.5 (~RAS), U50.5 (~RAS)
~RAS1: U41.5 (~RAS), U51.5 (~RAS)
~VMEMR: U31.15 (~MRD)
~WE: U40.4 (~W), U41.4 (~W), U50.4 (~W), U51.4 (~W)

Notes on the sheet:
IBM 1501458 (L1C0092 or C04738)
