schlae/EGACard/Sheet8.kicad_sch

## KiCad design Sheet8.kicad_sch (2024-01-20)

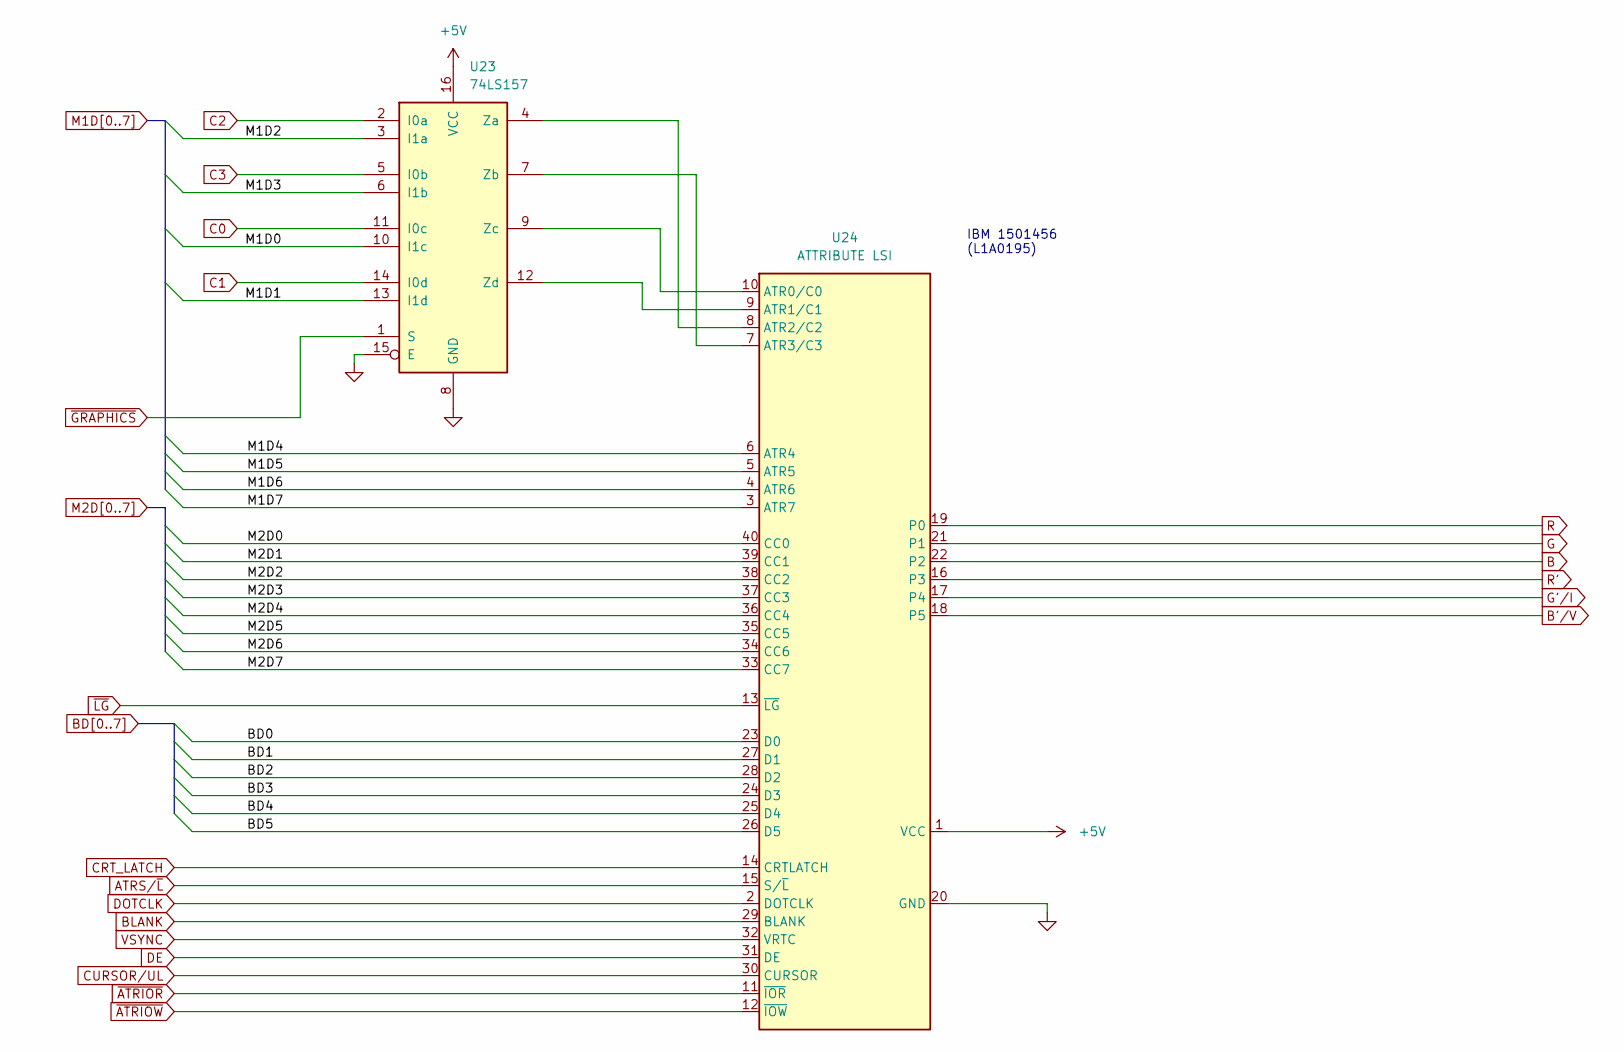
[picture p9: schematic Sheet8.kicad_sch]

Parts:
U23: 74LS157; DIP254P762X635-16
U24: ATTRIBUTE LSI; DIP254P1524X635-40

Connections:
+5V: U23.16 (VCC), U24.1 (VCC)
ATRS/~L: U24.15 (S/~L)
B: U24.22 (P2)
B'/V: U24.18 (P5)
BD0: U24.23 (D0)
BD1: U24.27 (D1)
BD2: U24.28 (D2)
BD3: U24.24 (D3)
BD4: U24.25 (D4)
BD5: U24.26 (D5)
BLANK: U24.29 (BLANK)
C0: U23.11 (I0c)
C1: U23.14 (I0d)
C2: U23.2 (I0a)
C3: U23.5 (I0b)
CRT_LATCH: U24.14 (CRTLATCH)
CURSOR/UL: U24.30 (CURSOR)
DE: U24.31 (DE)
DOTCLK: U24.2 (DOTCLK)
G: U24.21 (P1)
G'/I: U24.17 (P4)
GND: U23.8 (GND), U23.15 (E), U24.20 (GND)
M1D0: U23.10 (I1c)
M1D1: U23.13 (I1d)
M1D2: U23.3 (I1a)
M1D3: U23.6 (I1b)
M1D4: U24.6 (ATR4)
M1D5: U24.5 (ATR5)
M1D6: U24.4 (ATR6)
M1D7: U24.3 (ATR7)
M2D0: U24.40 (CC0)
M2D1: U24.39 (CC1)
M2D2: U24.38 (CC2)
M2D3: U24.37 (CC3)
M2D4: U24.36 (CC4)
M2D5: U24.35 (CC5)
M2D6: U24.34 (CC6)
M2D7: U24.33 (CC7)
unnamed: U23.4 (Za), U24.8 (ATR2/C2)
unnamed: U23.7 (Zb), U24.7 (ATR3/C3)
unnamed: U23.9 (Zc), U24.10 (ATR0/C0)
unnamed: U23.12 (Zd), U24.9 (ATR1/C1)
R: U24.19 (P0)
R': U24.16 (P3)
VSYNC: U24.32 (VRTC)
~ATRIOR: U24.11 (~IOR)
~ATRIOW: U24.12 (~IOW)
~GRAPHICS: U23.1 (S)
~LG: U24.13 (~LG)

Notes on the sheet:
IBM 1501456 (L1A0195)
