schlae/EGACard/Sheet9.kicad_sch

## KiCad design Sheet9.kicad_sch (2024-01-29)

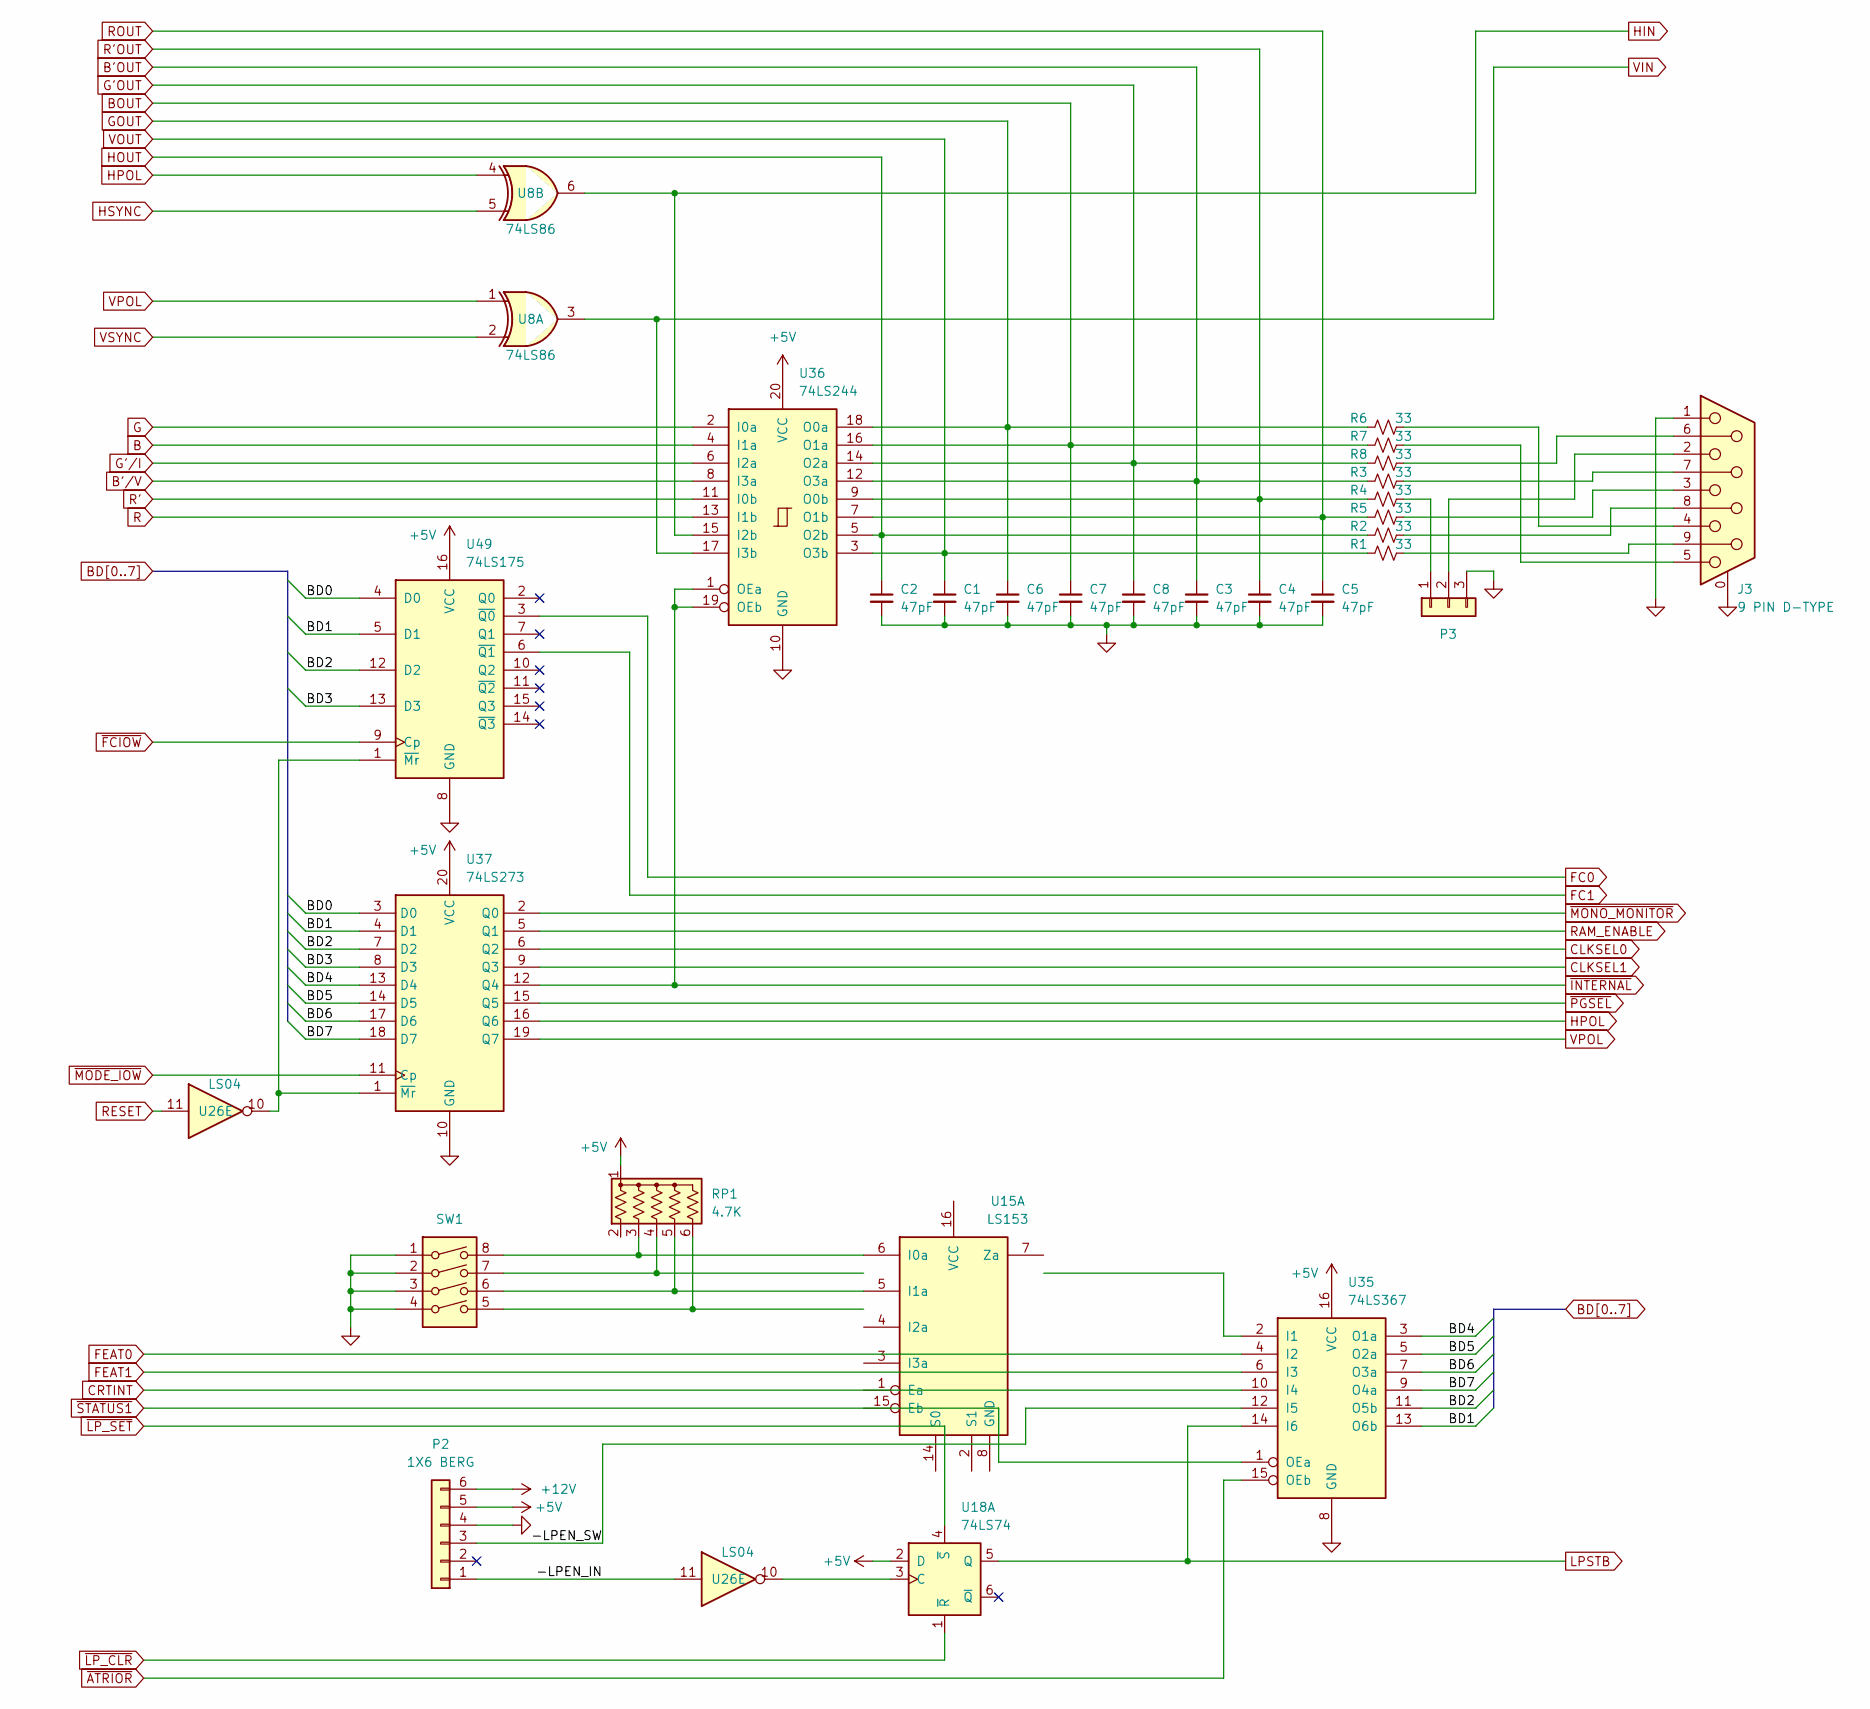
[picture p10: schematic Sheet9.kicad_sch]

Parts:
C1, C2, C3, C4, C5, C6, C7, C8: 47pF; CAPAC1234
J3: 9 PIN D-TYPE; DB9-RA
P2: 1X6 BERG; PinHeader_1x06_P2.54mm_Vertical
P3: 1 x 3 BERG; PinHeader_1x03_P2.54mm_Vertical
R1, R2, R3, R4, R5, R6, R7, R8: 33; RESA500
RP1: 4.7K; R_Array_SIP6
SW1: SW_DIP_x04; DIP254P762X635-8
U8: 74LS86; DIP254P762X635-14
U15: LS153; DIP254P762X635-16
U18: 74LS74; DIP254P762X635-14
U26: LS04; DIP254P762X635-14
U35: 74LS367; DIP254P762X635-16
U36: 74LS244; DIP254P762X635-20
U37: 74LS273; DIP254P762X635-20
U49: 74LS175; DIP254P762X635-16

Connections:
+5V: P2.5, RP1.1 (common), U18.2 (D), U35.16 (VCC), U36.20 (VCC), U37.20 (VCC), U49.16 (VCC)
+12V: P2.6
-LPEN_IN: P2.1, U26.11
-LPEN_SW: P2.3, U35.12 (I5)
B: U36.4 (I1a)
B'OUT: C3.1, R3.1, U36.12 (O3a)
B'/V: U36.8 (I3a)
BD0: U37.3 (D0), U49.4 (D0)
BD1: U35.13 (O6b), U37.4 (D1), U49.5 (D1)
BD2: U35.11 (O5b), U37.7 (D2), U49.12 (D2)
BD3: U37.8 (D3), U49.13 (D3)
BD4: U35.3 (O1a), U37.13 (D4)
BD5: U35.5 (O2a), U37.14 (D5)
BD6: U35.7 (O3a), U37.17 (D6)
BD7: U35.9 (O4a), U37.18 (D7)
BOUT: C7.1, R7.1, U36.16 (O1a)
CLKSEL0: U37.6 (Q2)
CLKSEL1: U37.9 (Q3)
CRTINT: U35.10 (I4)
FC0: U49.3 (~Q0)
FC1: U49.6 (~Q1)
FEAT0: U35.4 (I2)
FEAT1: U35.6 (I3)
G: U36.2 (I0a)
G'OUT: C8.1, R8.1, U36.14 (O2a)
G'/I: U36.6 (I2a)
GND: C1.2, C2.2, C3.2, C4.2, C5.2, C6.2, C7.2, C8.2, J3.0 (PAD), J3.1, P2.4, P3.3, SW1.1, SW1.2, SW1.3, SW1.4, U35.8 (GND), U36.10 (GND), U37.10 (GND), U49.8 (GND)
GOUT: C6.1, R6.1, U36.18 (O0a)
HIN: U8.6, U36.15 (I2b)
HOUT: C2.1, R2.1, U36.5 (O2b)
HPOL: U8.4, U37.16 (Q6)
HSYNC: U8.5
LPSTB: U18.5 (Q), U35.14 (I6)
unnamed: J3.2, P3.2
unnamed: J3.3, R5.2
unnamed: J3.4, R6.2
unnamed: J3.5, R7.2
unnamed: J3.6, R8.2
unnamed: J3.7, R3.2
unnamed: J3.8, R2.2
unnamed: J3.9, R1.2
unnamed: P3.1, R4.2
unnamed: RP1.3 (R2), SW1.8, U15.6 (I0a)
unnamed: RP1.4 (R3), SW1.7
unnamed: RP1.5 (R4), SW1.6, U15.5 (I1a)
unnamed: RP1.6 (R5), SW1.5
unnamed: U18.3 (C), U26.10
unnamed: U26.10, U37.1 (~Mr), U49.1 (~Mr)
R: U36.13 (I1b)
R': U36.11 (I0b)
R'OUT: C4.1, R4.1, U36.9 (O0b)
RAM_ENABLE: U37.5 (Q1)
RESET: U26.11
ROUT: C5.1, R5.1, U36.7 (O1b)
VIN: U8.3, U36.17 (I3b)
VOUT: C1.1, R1.1, U36.3 (O3b)
VPOL: U8.1, U37.19 (Q7)
VSYNC: U8.2
~ATRIOR: U35.15 (OEb)
~FCIOW: U49.9 (Cp)
~INTERNAL: U36.1 (OEa), U36.19 (OEb), U37.12 (Q4)
~LP_CLR: U18.1 (~R)
~LP_SET: U18.4 (~S)
~MODE_IOW: U37.11 (Cp)
~MONO_MONITOR: U37.2 (Q0)
~PGSEL: U37.15 (Q5)
~STATUS1: U35.1 (OEa)
