schlae/EGACard/Sheet10.kicad_sch

## KiCad design Sheet10.kicad_sch (2024-01-20)

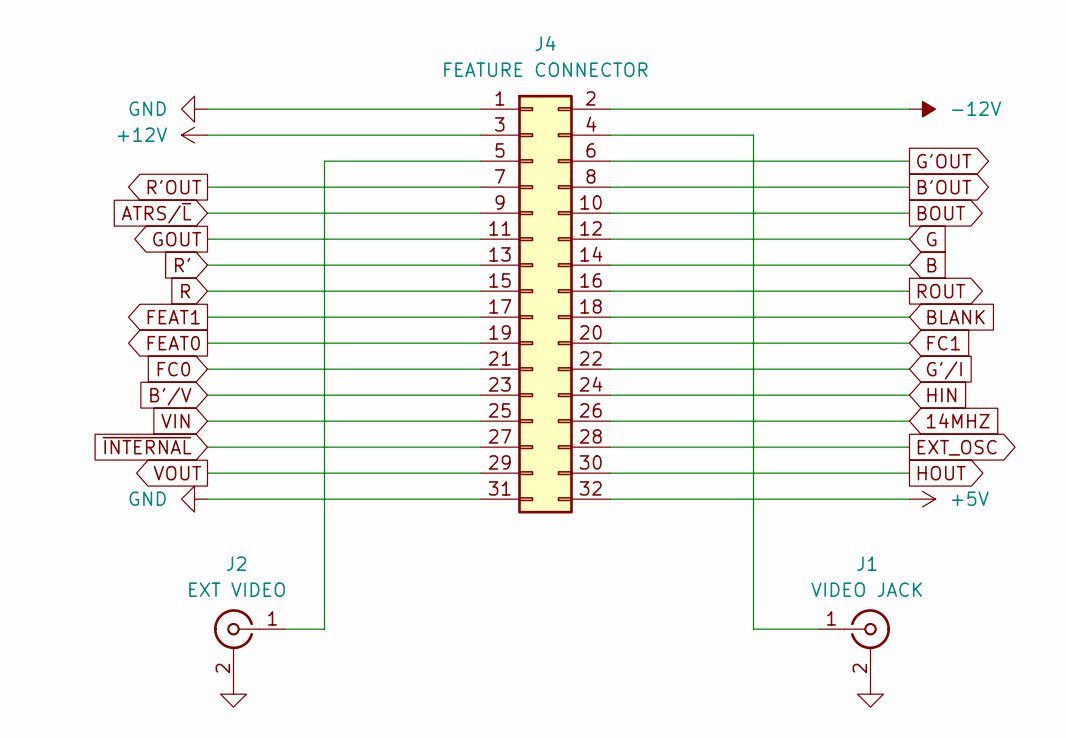
[picture p11: schematic Sheet10.kicad_sch]

Parts:
J1: VIDEO JACK; RCA_JACK
J2: EXT VIDEO; RCA_JACK
J4: FEATURE CONNECTOR; PinHeader_2x16_P2.54mm_Vertical

Connections:
14MHZ: J4.26
+5V: J4.32
+12V: J4.3
-12V: J4.2
ATRS/~L: J4.9
B: J4.14
B'OUT: J4.8
B'/V: J4.23
BLANK: J4.18
BOUT: J4.10
EXT_OSC: J4.28
FC0: J4.21
FC1: J4.20
FEAT0: J4.19
FEAT1: J4.17
G: J4.12
G'OUT: J4.6
G'/I: J4.22
GND: J1.2 (Ext), J2.2 (Ext), J4.1, J4.31
GOUT: J4.11
HIN: J4.24
HOUT: J4.30
unnamed: J1.1 (In), J4.4
unnamed: J2.1 (In), J4.5
R: J4.15
R': J4.13
R'OUT: J4.7
ROUT: J4.16
VIN: J4.25
VOUT: J4.29
~INTERNAL: J4.27
